davidpalma666/FED3.1-PCB-v7.x-FORK/_FED3.1 notes.txt

> meu repositório FORK
https://github.com/davidpalma666/FED3.1-PCB-v7.x-FORK

> o reposit´rio main

> doc instruções
https://docs.google.com/document/d/1KJnj2vmsR2Gq2-051aAo4KDC9eWGih1XZerS2I0B4w4/edit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

*************************************************
*	@30 Outubro 2025
*
> ontem Filipe com problemas na programação das 1ªs placas do lote de 200:
	- nem todas as placas ficavam programadas/havia-outros-erros diferentes numa amostragem de 10 PCBs

> veio-se a perceber q o problema derivava do cabo & ficha USB-tipoC
	- a ficha ficava com folga: neste momento não na PCB, apenas na máquina do Filipe
	- a forma como o cabo estava a ir no 'ar' da máquina para a PCB criava força de momento na ligação não ficando OK
	- a máquina do Filipe já ter 'muita' folga na ficha??? Talvez
	
> ficou esclarecido & reposto & garantindo a ligação mecânica firme da ficha-cabo à ficha-máquina

>mas anteve-se problemas futuros para o utilizador:
	- esta fragilidade mecânica do microUSB vai-se repercutir na PCB
	- em boards FED3 depois de utilizadas muitas vezes, a robustez mecânica da ficha vai enfraquecer & danificar contacto eléctrico
	- terá a ver com o 'cuidado' do utilizador? Tb, sim
	- mas a própria estrutura mecânica de soldadura da ficha é frágil e neste 1º lote os pinos mecânicos não vêem soldados - pinos TH sem soldadura no bottom layer
		!!!!! questão a ver com o produtor das PCBs na produção de um próximo lote

*************************************************
*	@29 Outubro 2025
*
> adicionada folder de \_fw ao commited

*************************************************
*	@15 Outubro 2025
*
." sincronizar o meu fork com o main branch" 
>> (??) já estava sincronizado?? havia files ainda diferentes;

>> garantia de sincronia com o main branch agora!!!

*************************************************
*	@26 Agosto 2025
*
>> FED3.1
	. meu @8 Agosto
		. Foi programado e viu-se as coisas a 'mexer', power e programação e LCD ok
		
	. Filipe @21 Agosto
			Percebi que o FED3 não carregava com um dos carregadores USB-C que tinha comigo
			Depis de várias testes, uma resistência de 1k ohm entre os 5V da ficha USB e GND resolveu.
					Dou como terminado oo desenvolvimento do FED3

			Fica aqui o link para a versão com a resistência entre a tensão de 5V da ficha USB e GND. Usei 330 ohms para termos mais corrente.
			https://github.com/KravitzLabDevices/FED3/tree/df9cc5ba60b0ba6e178a161061aa71733f4ab352
		. ecrã do FED3 passa a ter o OEPS PN OEPS100071
		. em produção 200un 
			
		. há ainda as PNs a corrigir no projecto?? 
		
		. sincronizar o meu fork com o main branch

*************************************************
*	@4 Julho 2025
*
- hw foi para produção
- footprints não totalmente em sintonia com as Libraries - propriedades mudadas
	- MPN corrigidos pelo Filipe
	- ficha USB & jack & switch: alterados para componentes SMD
	- gerado novos ficheiros P&P
	- mais algum alterado?? unsepecified 2 SMD?? - aqueles acima eram os criticos para aparecerem no P&P
	- redesenhado layer de Fabrication

- produzir documentação para Manufacturers programarem fws: para testes & final

*************************************************
*	@2 Julho 2025
*

from jonnew
https://github.com/KravitzLabDevices/FED3/issues/13

. Review of hardware 7.4 #13

1. "huge circle in the top silk layer"
Don't have that circle on my 'fork' version.
Also noticed about other differences on PCB file:
 . layers setup to be diferent - which layer were hidden or not
 . 'Zone Fills' to be drawn as Filled-Areas or Outlined
 
 While looking & working is perfectly legitim to change setups mentioned above.
 Maybe while doing it got that huge circle designed by mystake??
 For now can't imagine other reason...

2. "Fab layers are a mess".
Fab is short for "fabrication" layer (not "fabulous" as you might have guessed).
There's no requirement for it to contain anything or even to be sent to the PCB maker
It's can be used as PCB design auxiliary. Or time loosing if you won't used it for anything.
Characters & Numbers & Draws that will be printed on board are on Silkcreen layers, and this layers got and are 'clean'.

3. "board version (7.4) is nowhere that I can see."

*************************************************
*	@28 Maio 2025
*	

- headers ou sockets 2x3 para programação? 
	- o q é mais barato para utilizar na programação?
	- headeers sempre mais baratos q sockets
		- headers ~0.06€ / un @100n
			https://www.digikey.com/en/products/detail/metz-connect-usa-inc/PR20203VBDN/12342894
		- sockets ~0.25€ / un @100un
			https://www.digikey.com/en/products/detail/adam-tech/RS2-06-G/9832064
			
		>> UTILIZAR HEADERS;
		
- modificado pinout no header de programação para q GND & 3V3 não fiquem próximos
		OK

*************************************************
*	@27 Maio 2025
*

- v. corrigida na board para v.7.4 		OK

- USB: D+ & D- trocados ficha	- corrigido OK

- observação do Sérgio:
	. case de X2 não corresponde à do componente; difícil soldar
		- case corrigida	OK

- U2 MPN & OEPS corrigido
		OEPS080052	LDO 3.3V 300mA	SOT-23-5	SMD	MIC5504-3.3YM5-TR

*************************************************
*	@16 Maio 2025
*
- U2 - MPN errado
	. o q tá na component list:
		OEPS080165 
			MPN= SPX3819-3.3	NOK 
			SPN= MOUSER 701-SPX3819M5-L/TR	NOK
			Decription = LDO 3.3V 400mA 	NOK => Imax =500mA
		
		devia ser:
		SPX3819M5-L-3-3/TR	
			IC REG LINEAR 3.3V 500MA SOT23-5
		MPN = SPX3819M5-L-3-3/TR
		SPN =	1016-1873-6-ND		Digikey
					701-SPX3819M5-L-33TR 	Mouser
				
	. o utilizado agora para substituir:
		OEPS080052	LDO 3.3V 300mA	SOT-23-5	SMD	MIC5504-3.3YM5-TR
	>> FICOU ESTE O LDO A SER UTILIZADO

- USB: D+ & D- trocados ficha

*************************************************
*	@14 Maio 2025
*

>> revisão da programação do u SAMD21
	
	- o u é		ATSAMD21G18A		ATSAMD21G18A	 ARM Cortex M0
		. no kit	Adafruit Feather M0 Adalogger
			. ATSAMD21G18A - U - sem refª no pdf actual
			. ATSAMD21G18A-MU: TQFP48
			. OEPS100040 - OEPSPN do kit, não do u
	
		. na v.7.3 da PCB o u é:
			.  ATSAMD21G18A-MU	QFN48
			. OEPS080131

	- pinout fichas de Atmel-ICE programmer para  Feather M0 Adalogger 
	
		. tem de ser flat cable c\ condutores separados !!
				=>	o	o	o			#4	nc	#6				(top view & view from PCB edge)
						o	o	o			#1	#5	#2		
					
					=> AVR port => OK para o u !!!!!!!!!!!!1

		. pinout para condutores separados:	
				. AVR port
						#1 	SWCLCK		TCK	(verde)
						#2 	GND			GND
						#3 	n.c.				SWO = Serial Wire Output (optional- not implemented on all devices)
						#4 	3V3				VTG
						#5 	SWDIO		Serial Wire Debug Data Input/Output		(azul)
						#6 	RST				nRESET

				. SAM port
						#1 	3V3				VTG
						#2 	SWDIO		Serial Wire Debug Data Input/Output		(azul)
						#3 	GND			GND
						#4 	SWCLCK		TCK	(verde)
													#6	n.c.				SWO = Serial Wire Output (optional- not implemented on all devices)
						#10 	RST				nRESET

				. a ficha 3x2 não tem IOs necessários. Pinout:
						=>	#fio do flat q estão ligados na ficha 3x2	
						=>	o	o	o			#4	#9	#2				(top view)
								o	o	o			#3	#1	#6		
									||
						=>	FICHA NÃO UTILÁVEL EM NENHUMA DAS CONFIGURAÇÕES !!!

		- os ficheiros:
			. no UI Adafruit:
				1º bootloader setup:
					Tools -> Board -> SAMD21 boards -> Adafruit Feather M0
				2º bootloader upload:
						-> Tools -> Programmer: ATMEL-ICE
						-> Tools -> Burn bootloader
						
			. fw:	
				Tools -> Port -> COMx
					open 	\Documents\Arduino\libraries\FED3:	vários exemplos

*************************************************
*@15 Abril 2025

. RTC em versões anteriores:
	PCF8523T/1,118			SOIC8_150MIL	https://www.digikey.pt/en/products/detail/nxp-usa-inc/pcf8523t-1-118/2530422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
	
	package:	SO8 = SOIC8_150MIL = OEPS080167

. RTC para versão 7.3:
	PCF8523T K/1,118		
	package	HVSON8_4X4	??
		não - manteve-se a pesma package => mesmo PN

*************************************************
*@14 Abril 2025

. old v.7.2
	M74VHC1GT50DTT1G no .scmh
		IC3	1	IC BUFF CMOS LVL/SFTR N-I 5TSOP	SMD	M74VHC1GT125DT1G	Digi-Key	M74VHC1GT125DT1GOSCT-ND	

. new v.7.3
	SN74LV1T125DBVR
	- na v.7.2 valores no Scmh. e na BOM são diferentes
	- na BOM o valor é SN74LV1T125DBVR
	- é o q faz sentido com o desenho no Schm.

*************************************************
*@5 Fevereiro 2025
	https://developerhelp.microchip.com/xwiki/bin/view/products/mcu-mpu/8-bit-avr/structure/fuses/

*************************************************
*@28 Janeiro 2025

https://forum.arduino.cc/t/solved-programming-a-samd21-with-the-atmel-ice-from-the-ide/434482
	
	>> to get rid of it and use the ATMEL-ICE and program the boards via SWD (Atmel-Ice não para pinos SWD??)
		- para quê o SWD??
		
	- The way that I do it right now is 
	1. I burn a sketch on a dev board via USB, 
	2. then read the flash with Atmel Studio, 
	3. and use that image to flash the other boards 
	...This is a bit a pain in the ass, as I changed the footprint of my programming socket in the board, and I have to fiddle with wires everytime I switch boards.

	Has somebody been successful using the IDE and the ATMEL-ICE to flash SAMD21 chips??
	
	Hi, you need to compile your code using a different linker script:

*************************************************
*@27 Janeiro 2025

>>meta para conseguir programar o micro:

	1. programar o bootloader no micro ainda virgem e 
	
		- para programar micro ainda virgem será necessário header SwClck & SwDIO & \Reset	>>	OK
		
		- micro pode ser programado pela porta SAMD21 ou IDE do programador : 
			. pinout do flat cable diferente; ver pic no caderno		>>	OK
		
		- é realmente necessário colocar bootloader ?? ... 
			. sim, para a seguir o micro ficar programável por USB		>>	OK
		
		- tem de ser todo o código do kit Adafruitxxx da placas já com bootloader & IO-setup etc, ou
			ou,
			haverá código q é apenas o bootloader & COMM setup - sem mais nada & mais simples?

	2. colocar depois o nosso código 
		- via USB & o nosso programa OEPS-programming	>>OK ????
		
		- pq não continuar a usar o AdaProgrammer via SwClck & SwDIO & \Reset??

	3. o micro
	Adafruit Feather M0 Adalogger
	ATSAMD21G18AU
	ATSAM D21 G 18A -U
		OEPS080131	ATSAM D21 G 18A- MU		
		IC MCU 32BIT 256KB FLASH 48QFN	48-VFQFN Exposed Pad	SMD	ATSAMD21G18A-MU

	https://pt.farnell.com/microchip/atsamd21g18a-mf/mcu-32bit-cortex-m0-48mhz-qfn/dp/2460544
	
	:: de SAM D21 family .pdf
	- Note that a pull-up resistor on the SWCLK pin is critical for reliable operations. Refer to related link for more information.

*************************************************
*@24 Janeiro 2025
- novo switch a mudar/implementar no desenho - mais pequeno
	filtro:
	https://www.digikey.pt/en/products/filter/tactile-switches/197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
	
	modelo
	https://www.digikey.pt/en/products/detail/e-switch/TL3305BF260QG/5816185
	E-Switch
	4.5 X 4.5 mm
	0.25@1		0.16@100
	MPN: TL3305BF260QG
	Digikey: EG5354CT-ND

*************************************************
*@23 Janeiro 2025

>> escolha reset switch dentro do q já temos
OTHER:   SWITCH TACTILE SPST-NO 0.05A 24V   [B3F-1002] [TH]	OEPS100011	TH	B3F-1002		https://www.digikey.pt/en/products/detail/omron-electronics-inc-emc-div/b3f-1002/11881
	side-switch 	NOK

OTHER:   SWITCH TACTILE SPST-NO 0.05A 24V   [B3F-4000] [TH]	OEPS100020	TH	B3F-4000	1	DigiKey	SW411-ND
https://www.digikey.pt/en/products/detail/omron-electronics-inc-emc-div/b3f-4000/63961
	12mm x 12mm;	4.3mm height		flat type OK		
	há mais peq q 12x12	- NOK- grande	

OTHER:   SWITCH TACTILE SPST-NO 0.05A 50V   [CT11027.0F160] [TH]	OEPS100056	TH	CT11027.0F160	1	Digikey	2449-CT11027.0F160-ND
https://www.digikey.pt/en/products/detail/cit-relay-and-switch/ct11027-0f160/12502785
	CT1102	standard
		7.0	actuator height
		F160	actuator force
		XxY = 6mm x 6mm
			OK?? 	maior......

*************************************************
*@21 Janeiro 2025

- Board redesenhada: integração de Atmel 'as-is' na nossa board

>> substituir componentes da board Atmel, por componentes nossos & similares:
	- D2		
			Schottky	MBR120	
				Case													SOD-123
				Voltage - DC Reverse (Vr) (Max)		20 V
				Current - Average Rectified (Io)		1A
				Voltage - Forward (Vf) (Max) @ If	450 mV @ 1 A
				Speed												Fast Recovery =< 500ns, > 200mA (Io)
			
			SM5817PL-TP			OEPS030030
				Case 		SOD-123FL			<<<<<<<<<<<<<<<<!!!!!!!!! OK ???
				Voltage - DC Reverse (Vr) (Max)		20 V
				Current - Average Rectified (Io)		1A
				Voltage - Forward (Vf) (Max) @ If	450 mV @ 1 A
				Speed									Fast Recovery =< 500ns, > 200mA (Io)

	- RGB LEDs
			- spec apenas leva até case & protocolo comm..			https://www.digikey.pt/en/products/filter/led-addressable-specialty/126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

		L0	Red
			OEPS030006	LED 0603 Red 635nm 20mA	0603	SMD	5975004407F	10	DigiKey	350-2950-6-ND
			>> OK
		
	 - Green LEDs
	OEPS030005= DigiKey: 160-1446-6-ND
	>>> OK

	- SW2	Reset switch	Push-Butt SMD	
		a escolher dos nossos
	
	- 10uF		Cs com case 0402 muito mais caros q case 0603? E disponibilidade??
		a escolher dos nossos

>>lista re-enviada ao Filipe @ 23 Janeiro 

	- USB micro plug	.Actual one:	. OEPS070062USB 2.0 MICRO B R/ASMD/THZX62D-B-5P8(30)1DigiKey H125272DKR-ND	> obsolete - last production by November 2025	> 0.30€ expensive than new one		> new one below fully compatible electrically & mechanically 	

	. NEW micro plug	https://www.digikey.pt/en/products/detail/hirose-electric-co-ltd/ZX62D-B-5PA8-30/5994877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	USB 2.0 MICRO B R/A	SMD/TH	MPN: ZX62D-B-5PA8(30)	DigiKey: H125718CT-ND	OEPSPN: OEPS07????
	
	- SW1main switchmanter o mesmo(?) pq (re-)integração mecânica mais fácil	https://www.digikey.pt/en/products/detail/alps-alpine/ssss811101/19529062	Slide Switch SPDT Surface Mount, Right Angle 0.3A 5V	MPN: SSSS811101	Digikey: 4809-SSSS811101CT-ND	OEPSPN: OEPS10????

	Micro SDCard conn	https://www.digikey.pt/en/products/detail/w%C3%BCrth-elektronik/693071010811/3124583	CONN MICRO SD CARD PUSH-PUSH R/A		SMD	MPN	693071010811	Digikey	732-3819-1-ND	OEPS07????					
	
	IC BUF NON-INVERT 1CH 5.5V 	https://www.digikey.pt/en/products/detail/texas-instruments/SN74LV1T125DBVR/4555571	SOT23-5	MPN	SN74LV1T125DBVR	Digikey	296-37172-1-ND	OEPSPN	OEPS08????					
	
	IC BATT CNTL LI-ION 1CEL 	https://www.digikey.pt/en/products/detail/microchip-technology/mcp73831t-2aci-ot/964301	SOT23-5	MPN	MCP73831T-2ACI/OT	Digikey	MCP73831T-2ACI/OTCT-ND	OEPSPN	OEPS08????						
	
	IC MOTOR DRIVER 2.7V-5.5V 	https://www.digikey.pt/en/products/detail/toshiba-semiconductor-and-storage/tb6612fng-c-8-el/1730070	24SSOP	MPN	TB6612FNG,C,8,EL	Digikey	TB6612FNGC8ELCT-ND	OEPSPN	OEPS08????					
	
	IC RTC CLOCK/CALENDAR I2C 	https://www.digikey.pt/en/products/detail/nxp-usa-inc/pcf8523t-1-118/2530422	8SO	MPN	PCF8523T/1,118	Digikey	568-5306-1-ND	OEPSPN	OEPS0?????					
	
	XTAL 32.7680KHZ ±10ppm 12.pPF SMD	https://www.digikey.pt/en/products/detail/ecs-inc/ECS-327-12-5-17X-C-TR/2781917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	SMD	MPN	ECS-.327-12.5-17X-C-TR	Digikey	XC1912CT-ND	OEPSPN	OEPS03????					
	
	Battery Retainer Coin, 12.0mm 1 Cell	https://www.digikey.pt/en/products/detail/keystone-electronics/3000/227440	SMD	MPN	3000	Digikey	36-3000-ND	OEPSPN	OEPS0?????
	
	Optical Sensor Through-Beam 10mm PCB Mount	https://www.digikey.pt/en/products/detail/sharp-socle-technology/gp1a57hrj00f/718287	MPN	GP1A57HRJ00F	Digikey	1855-1043-ND	OEPSPN	OEPS??????					
	
	GRAPHIC DISPLAY LCD BLACK (GRAY)	https://www.digikey.pt/en/products/detail/adafruit-industries-llc/3502/7386264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	MPN	3502	Digikey	1528-2326-ND	OEPSPN	OEPS??????							

*************************************************
*@2 Janeiro 2025

	:: início Janeiro 2025
	1. FED3.1	> produto de controle acção-recompensa para ratos
		- objectivo:
			integração do kit Arduino 'Feather M0 Adalogger' na nossa main board FED3.1

. 	O FED3 base PCB está nesta pasta do Google Drive
\production files\FED3\OEPS-7504 - FED3.1 PCB\pcb\v7.2\oeps files\

. A BOM na pasta
\production files\FED3\OEPS-7504 - FED3.1 PCB\pcb\v7.2\production files\

. Este é o módulo Adafruit 	Adafruit Feather M0 Adalogger
	https://www.adafruit.com/product/2796
	
	 Feather M0's heart is an ATSAMD21G18 ARM Cortex M0 processor
	
. Os ficheiros do módulo Adalogger
	https://github.com/adafruit/Adafruit-Feather-M0-Adalogger-PCB

**************************************************************************************************
**************************************************************************************************
