davidpalma666/FED3.1-PCB-v7.x-FORK/pcb/_auxs/FED3_v7.2_BOM_simplified.xlsx

Schematic Name / Name | Qtty. | Description | Type | Manufacturer PN
IC1 | 1 | RTC (SOIC8_150MIL) | SMD | PCF8523T/1,118
IC2 | 1 | Motor driver (SSOP24) | SMD | TB6612FNG,C,8,EL
IC3 | 1 | IC BUFF CMOS LVL/SFTR N-I 5TSOP | SMD | M74VHC1GT125DT1G
R1, R2, R3, R6 | 4 | RES SMD 0805 1kΩ 1% 125mW | SMD | RC0805FR-071KL
R4, R5, R8 | 3 | RES SMD 0805 4.7kΩ 1% 125mW | SMD | RC0805FR-074K7L
R9 | 1 | RES SMD 0805 33kΩ 1% 125mW | SMD | CR0805-FX-3302ELF
R7 (DNI) | 0 | - | SMD | -
R12 | 1 | CAP SMD 0805 470Ω 1% 125mW | SMD | ERJ-6ENF4700V
C1, C2, C3, C4, C5, C6, C7, C8, C9, C10 | 10 | CAP SMD 0805 10uF 25V X5R 10% | SMD | TMK212BBJ106KG-T
Q1 | 1 | 32.768KHz Crystal | SMD | ECS-.327-12.5-17X-C-TR
Q3 | 1 | MOSFET 4V PCH | SMD | 755-RRR040P03TL
LED1, LED2, LED3, LED4, LED5, LED6, LED7, LED8, LED9, LED10 | 10 | RGB | SMD | SK6812RGBW-BW
B1 | 1 | CR1220 | SMD | Mouser: 534-3000
BEEP | 1 | Buzzer | TH | PS1240P02BT
USB | 1 | CONN RCPT USB MICRO B SMD | SMD/TH | ZX62D-B-5P8(30)
D1 | 1 | DIODE SCHOTTKY 25V 1.5A DO214AC | SMD | BYS10-25-E3/TR
SW1 | 1 | SWITCH | SMD | SSSS811101
EXT | 1 | AUDIO JACK | SMD | 35RASMT2BHNTRX
H7 FEATHER | 1 | Fem Header 1X12 100mil (2.54mm) | TH | CES-112-01-T-S
H5 FEATHER | 1 | Fem Header 1X16 100mil (2.54mm) | TH | CES-116-01-T-S
H3 MOTOR | 1 | Header 1x5 100mil (2.54mm) | TH | M20-9990546
PI1, PI2, PI3 | 3 | GP1A57HR | TH | GP1A57HRJ00F
X1 | 1 | JST CONN HEADER VERT 2POS 2MM | TH | B2B-PH-K-S(LF)(SN)
AUX_I2C (DNI) | 0 | DNI | - | -
H1 SCREEN | 1 | Header RA 1X6 100mil (2.54mm) | TH | 61300611021
This eval board is soldered by hand after the board is ready
EVAL BOARD | 1 | uC: Feather M0 Adalogger | - | DigiKey: 1528-1539-ND
HEADER FOR EVAL BOARD | 1 | Header 1X12 100mil (2.54mm) |  | TSW-112-06-T-S
HEADER FOR EVAL BAORD | 1 | Header 1X16 100mil (2.54mm) |  | TSW-116-06-T-S
This eval screen is soldered by hand after the board is ready
DISPLAY | 1 | SHARP memory display 1.3" 168x144 | - | DigiKey: 1528-2326-ND
SMD | 39
TH top | 6
TH bottom | 3
SMD different | 16
TH different | 7
