davidpalma666/FED3.1-PCB-v7.x-FORK/fw/_othersss/install and configure arduino packages.docx

Install:

- Arduino IDE v2.3.2 (available in the same folder as this file)
- File > Preferences > Additional Boards Manager URLs: https://adafruit.github.io/arduino-board-index/package_adafruit_index.json  Note: The list of URLs is comma separated
- The list of URLs is comma separated Board’s Management: Arduino SAMD Boards (32-bits ARM Cortex-M0+) v1.8.14
- Board’s Management: Adafruit SAMD Boards v1.7.3
- Library Management: FED3 v1.16.3 > INSTALL ALL

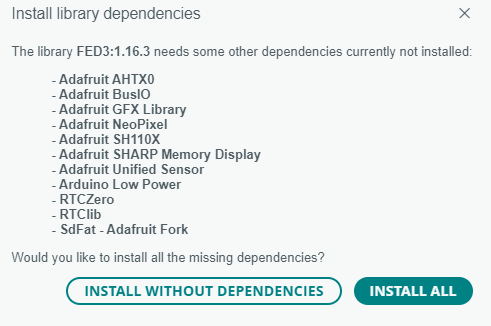
[picture p2: figure]
