davidpalma666/FED3.1-PCB-v7.x-FORK/pcb/v7.7/FED3.kicad_pcb

## KiCad design pcb/v7.7/FED3.kicad_pcb (2026-04-23)

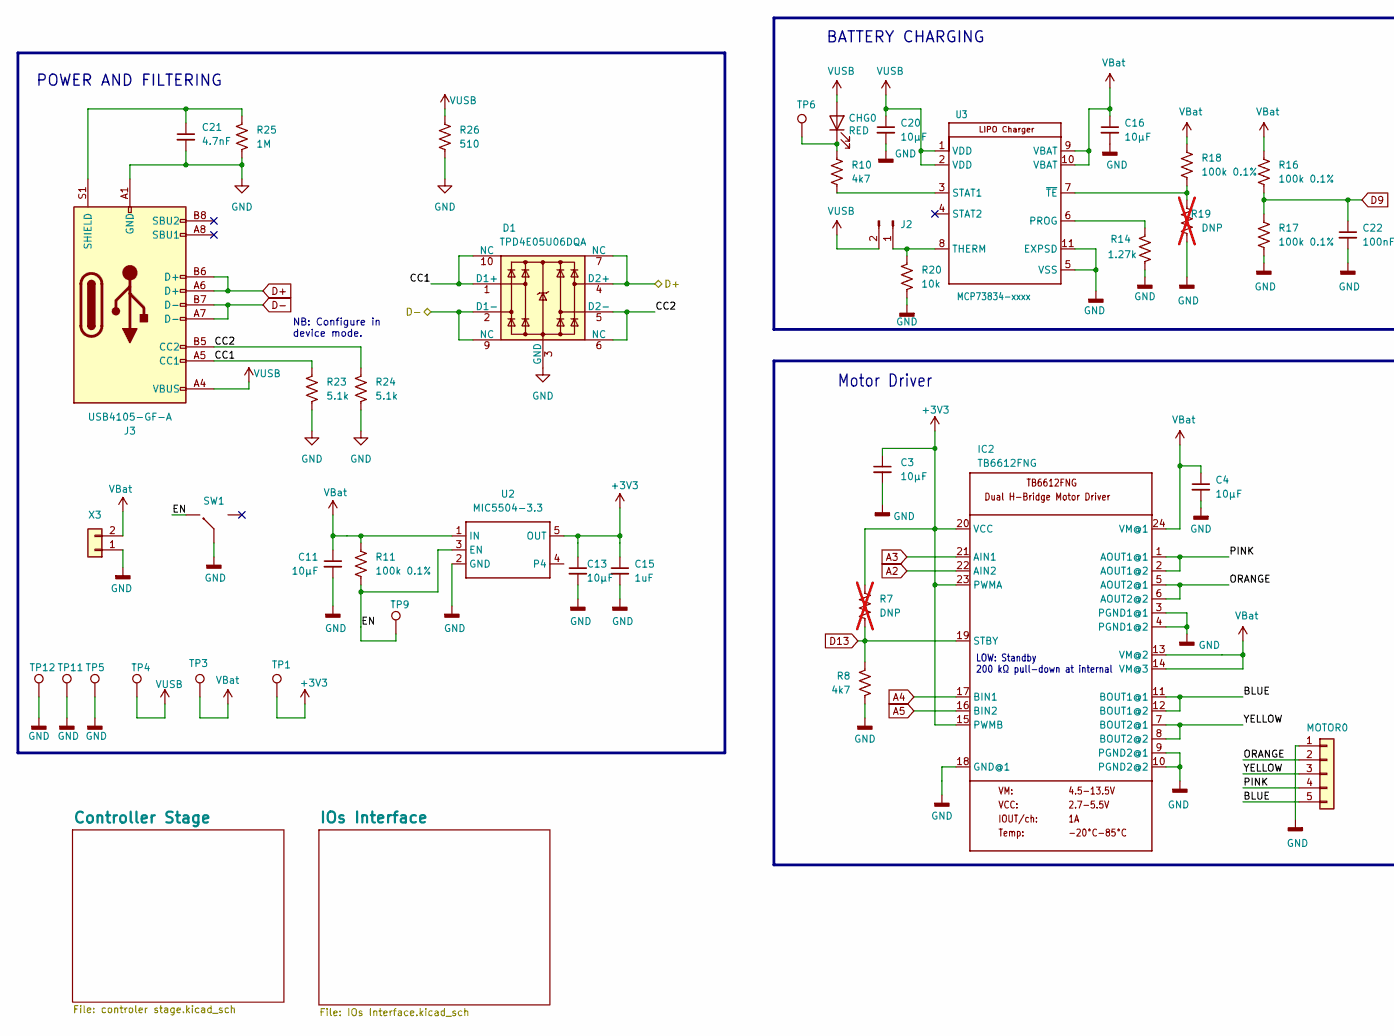
[picture p3: schematic FED3.kicad_sch, FED3 Control Board, part in row 1, column 1]

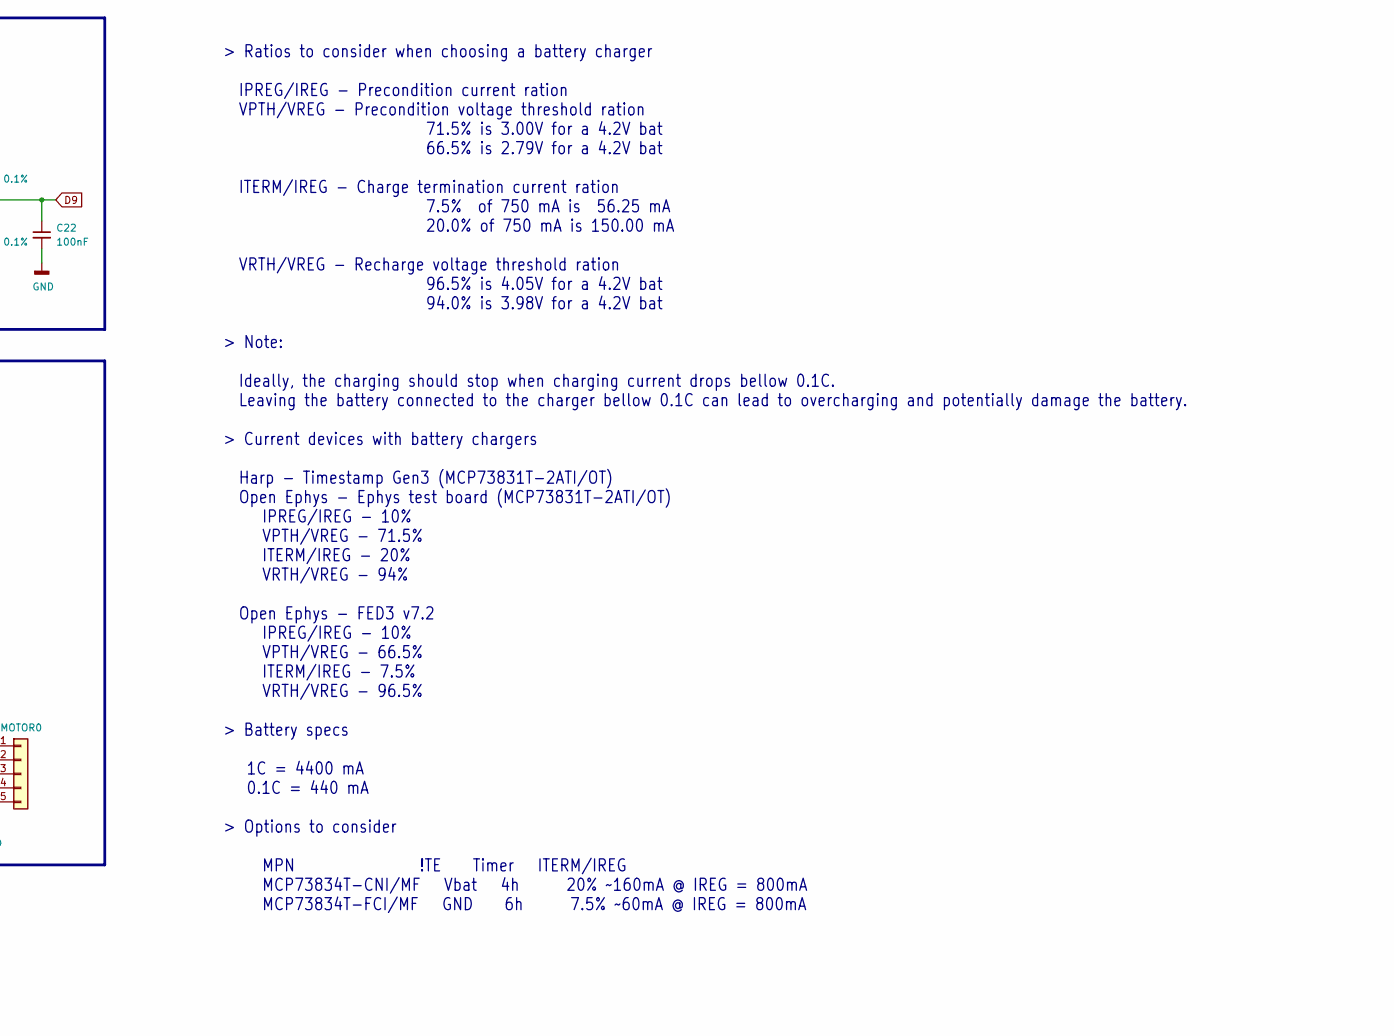
[picture p4: schematic FED3.kicad_sch, FED3 Control Board, part in row 1, column 2]

Parts:
C3, C4, C11, C13, C16, C20: 10µF; C_0402_1005Metric; MPN CL05A106MP5NUNC
C15: 1uF; C_0402_1005Metric; MPN C1005X5R1E105K050BC
C21: 4.7nF; C_0402_1005Metric; MPN 885012205084
C22: 100nF; C_0402_1005Metric; MPN C1005X7R1E104K050BB
CHG0: RED; LED_0603_1608Metric; MPN VFHR1116P-4C82A-TR
D1: TPD4E05U06DQA; USON-10_2.5x1.0mm_P0.5mm; MPN TPD4E05U06DQAR
IC2: TB6612FNG; SSOP24; MPN TB6612FNG,C,8,EL
J2: Conn_01x02_Odd_Even; PinHeader_1x02_P2.54mm_Vertical; MPN 68001-202HLF
J3: USB4105-GF-A; USB_C_Receptacle_GCT_USB4105-xx-A_16P_TopMnt_Horizontal; MPN USB4105-GF-A
MOTOR0: PINHD-1X5; 1X05; MPN M20-9990546
R7, R19: DNP; R_0402_1005Metric; MPN n.a.; not fitted
R8, R10: 4k7; R_0402_1005Metric; MPN ERJ-2RKF4701X
R11, R16, R17, R18: 100k 0.1%; R_0402_1005Metric; MPN RG1005P-104-B-T5
R14: 1.27k; R_0402_1005Metric; MPN CRCW04021K27FKED
R20: 10k; R_0402_1005Metric; MPN ERJ-2RKF1002X
R23, R24: 5.1k; R_0402_1005Metric; MPN ERJ-2RKF5101X
R25: 1M; R_0402_1005Metric; MPN CRCW04021M00FKED
R26: 510; R_0805_2012Metric; MPN ESR10EZPJ391
SW1: Sw; SSSS811101; MPN SSSS811101
TP1, TP6: 3V3; TestPoint_Pad_D2.0mm
TP3: VBat; TestPoint_Pad_D2.0mm
TP4, TP9: VUSB; TestPoint_Pad_D2.0mm
TP5, TP11, TP12: GND; TestPoint_Pad_D2.0mm
U2: MIC5504-3.3; SOT-23-5; MPN MIC5504-3.3YM5-TR
U3: MCP73834-xxxx; DFN-10-1EP_3x3mm_P0.5mm_EP1.58x2.35mm_ThermalVias; MPN MCP73834-CNI/MF
X3: B2B-PH-K-S; JST-XH-02-PACKAGE-ROUND-PAD; MPN B2B-PH-K-S(LF)(SN)

Connections:
+3V3: C3.1, C13.1, C15.1, IC2.15 (PWMB), IC2.20 (VCC), IC2.23 (PWMA), R7.2, TP1.1, U2.5 (OUT); also elsewhere on the board
/BLUE: IC2.11 (BOUT1@1), IC2.12 (BOUT1@2), MOTOR0.5
/CC1: D1.1 (D1+), D1.10 (NC), J3.A5 (CC1), R23.1
/CC2: D1.5 (D2-), D1.6 (NC), J3.B5 (CC2), R24.1
/EN: R11.2, SW1.1, TP9.1, U2.3 (EN)
/ORANGE: IC2.5 (AOUT2@1), IC2.6 (AOUT2@2), MOTOR0.2
/PINK: IC2.1 (AOUT1@1), IC2.2 (AOUT1@2), MOTOR0.4
/YELLOW: IC2.7 (BOUT2@1), IC2.8 (BOUT2@2), MOTOR0.3
A2: IC2.22 (AIN2); also elsewhere on the board
A3: IC2.21 (AIN1); also elsewhere on the board
A4: IC2.17 (BIN1); also elsewhere on the board
A5: IC2.16 (BIN2); also elsewhere on the board
D9: C22.1, R16.1, R17.1; also elsewhere on the board
D13: IC2.19 (STBY), R7.1, R8.2; also elsewhere on the board
D+: D1.4 (D2+), D1.7 (NC), J3.A6 (D+), J3.B6 (D+); also elsewhere on the board
D-: D1.2 (D1-), D1.9 (NC), J3.A7 (D-), J3.B7 (D-); also elsewhere on the board
GND: C3.2, C4.2, C11.2, C13.2, C15.2, C16.2, C20.2, C21.2, C22.2, D1.3 (GND), D1.8 (GND), IC2.3 (PGND1@1), IC2.4 (PGND1@2), IC2.9 (PGND2@1), IC2.10 (PGND2@2), IC2.18 (GND@1), J3.A1 (GND), J3.A12 (GND), J3.B1 (GND), J3.B12 (GND), MOTOR0.1, R8.1, R14.2, R17.2, R19.2, R20.2, R23.2, R24.2, R25.2, R26.2, SW1.2, TP5.1, TP11.1, TP12.1, U2.2 (GND), U3.5 (VSS), U3.11 (EXPSD), X3.1; also elsewhere on the board
unnamed: CHG0.1 (K), R10.1, TP6.1
unnamed: J2.1, R20.1, U3.8 (THERM)
unnamed: C21.1, J3.S1 (SHIELD), R25.1
unnamed: R14.1, U3.6 (PROG)
unnamed: R10.2, U3.3 (STAT1)
unnamed: R18.1, R19.1, U3.7 (~TE)
VBat: C4.1, C11.1, C16.1, IC2.13 (VM@2), IC2.14 (VM@3), IC2.24 (VM@1), R11.1, R16.2, R18.2, TP3.1, U2.1 (IN), U3.9 (VBAT), U3.10 (VBAT), X3.2; also elsewhere on the board
VUSB: C20.1, CHG0.2 (A), J2.2, J3.A4 (VBUS), J3.A9 (VBUS), J3.B4 (VBUS), J3.B9 (VBUS), R26.1, TP4.1, U3.1 (VDD), U3.2 (VDD)

Notes on the sheet:
Motor Driver
POWER AND FILTERING
BATTERY CHARGING
NB: Configure in device mode.
> Ratios to consider when choosing a battery charger IPREG/IREG - Precondition current ration VPTH/VREG - Precondition voltage threshold ration 71.5% is 3.00V for a 4.2V bat 66.5% is 2.79V for a 4.2V bat ITERM/IREG - Charge termination current ration 7.5% of 750 mA is 56.25 mA 20.0% of 750 mA is 15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
LOW: Standby 200 kΩ pull-down at internal

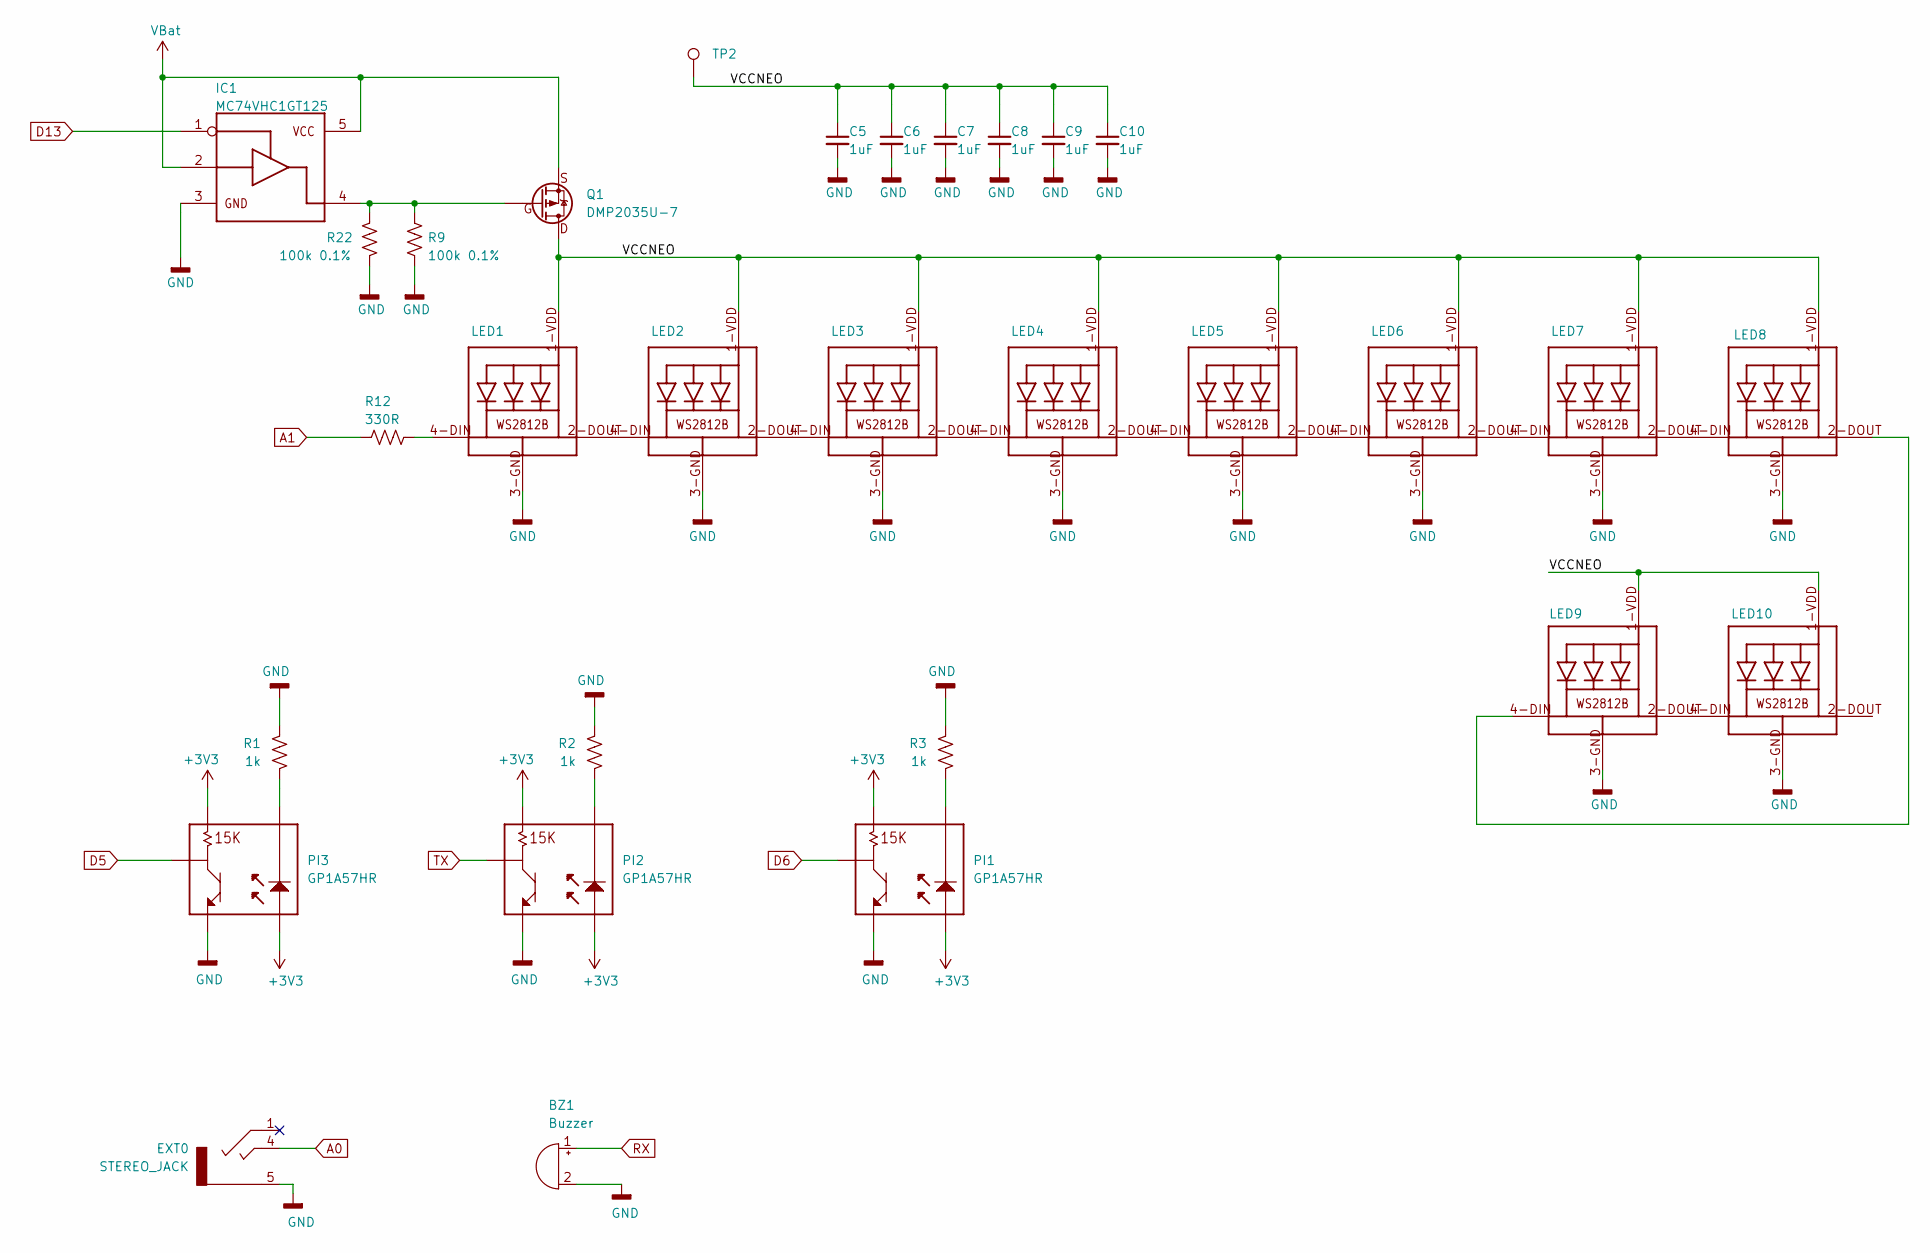
[picture p5: schematic IOs Interface.kicad_sch, FED3 Control Board]

Parts:
BZ1: Buzzer; MPN PS1240P02BT
C5, C6, C7, C8, C9, C10: 1uF; C_0402_1005Metric; MPN C1005X5R1E105K050BC
EXT0: STEREO_JACK; 35RASMT2BHNTRX; MPN 35RASMT2BHNTRX
IC1: MC74VHC1GT125; SOT-23-5; MPN MC74VHC1GT125DBVT1G
LED1, LED2, LED3, LED4, LED5, LED6, LED7, LED8, LED9, LED10: RGBLed; WS2812B; MPN XT1511RGBW-BW
PI1, PI2, PI3: GP1A57HR; MPN GP1A57HRJ00F
Q1: DMP2035U-7; TSMT3; MPN DMP2035U-7
R1, R2, R3: 1k; R_0402_1005Metric; MPN ERJ-2RKF1001X
R9, R22: 100k 0.1%; R_0402_1005Metric; MPN RG1005P-104-B-T5
R12: 330R; R_0402_1005Metric; MPN RC0402FR-07330RL
TP2: VccNEO; TestPoint_Pad_D2.0mm

Connections:
+3V3: PI1.1, PI1.3, PI2.1, PI2.3, PI3.1, PI3.3; also elsewhere on the board
/IOs Interface/VCCNEO: C5.1, C6.1, C7.1, C8.1, C9.1, C10.1, LED1.1-VDD (VDD), LED2.1-VDD (VDD), LED3.1-VDD (VDD), LED4.1-VDD (VDD), LED5.1-VDD (VDD), LED6.1-VDD (VDD), LED7.1-VDD (VDD), LED8.1-VDD (VDD), LED9.1-VDD (VDD), LED10.1-VDD (VDD), Q1.P$3 (D), TP2.1
A0: EXT0.4; also elsewhere on the board
A1: R12.2; also elsewhere on the board
D5: PI3.4; also elsewhere on the board
D6: PI1.4; also elsewhere on the board
D13: IC1.1; also elsewhere on the board
GND: BZ1.2 (-), C5.2, C6.2, C7.2, C8.2, C9.2, C10.2, EXT0.5, IC1.3, LED1.3-GND (GND), LED2.3-GND (GND), LED3.3-GND (GND), LED4.3-GND (GND), LED5.3-GND (GND), LED6.3-GND (GND), LED7.3-GND (GND), LED8.3-GND (GND), LED9.3-GND (GND), LED10.3-GND (GND), PI1.5, PI2.5, PI3.5, R1.2, R2.2, R3.2, R9.1, R22.1; also elsewhere on the board
unnamed: IC1.4, Q1.P$1 (G), R9.2, R22.2
unnamed: LED1.4-DIN (DI), R12.1
unnamed: LED1.2-DOUT (DO), LED2.4-DIN (DI)
unnamed: LED2.2-DOUT (DO), LED3.4-DIN (DI)
unnamed: LED3.2-DOUT (DO), LED4.4-DIN (DI)
unnamed: LED4.2-DOUT (DO), LED5.4-DIN (DI)
unnamed: LED5.2-DOUT (DO), LED6.4-DIN (DI)
unnamed: LED6.2-DOUT (DO), LED7.4-DIN (DI)
unnamed: LED7.2-DOUT (DO), LED8.4-DIN (DI)
unnamed: LED8.2-DOUT (DO), LED9.4-DIN (DI)
unnamed: LED9.2-DOUT (DO), LED10.4-DIN (DI)
unnamed: PI1.2, R3.1
unnamed: PI2.2, R2.1
unnamed: PI3.2, R1.1
RX: BZ1.1 (+); also elsewhere on the board
TX: PI2.4; also elsewhere on the board
VBat: IC1.2, IC1.5, Q1.P$2 (S); also elsewhere on the board

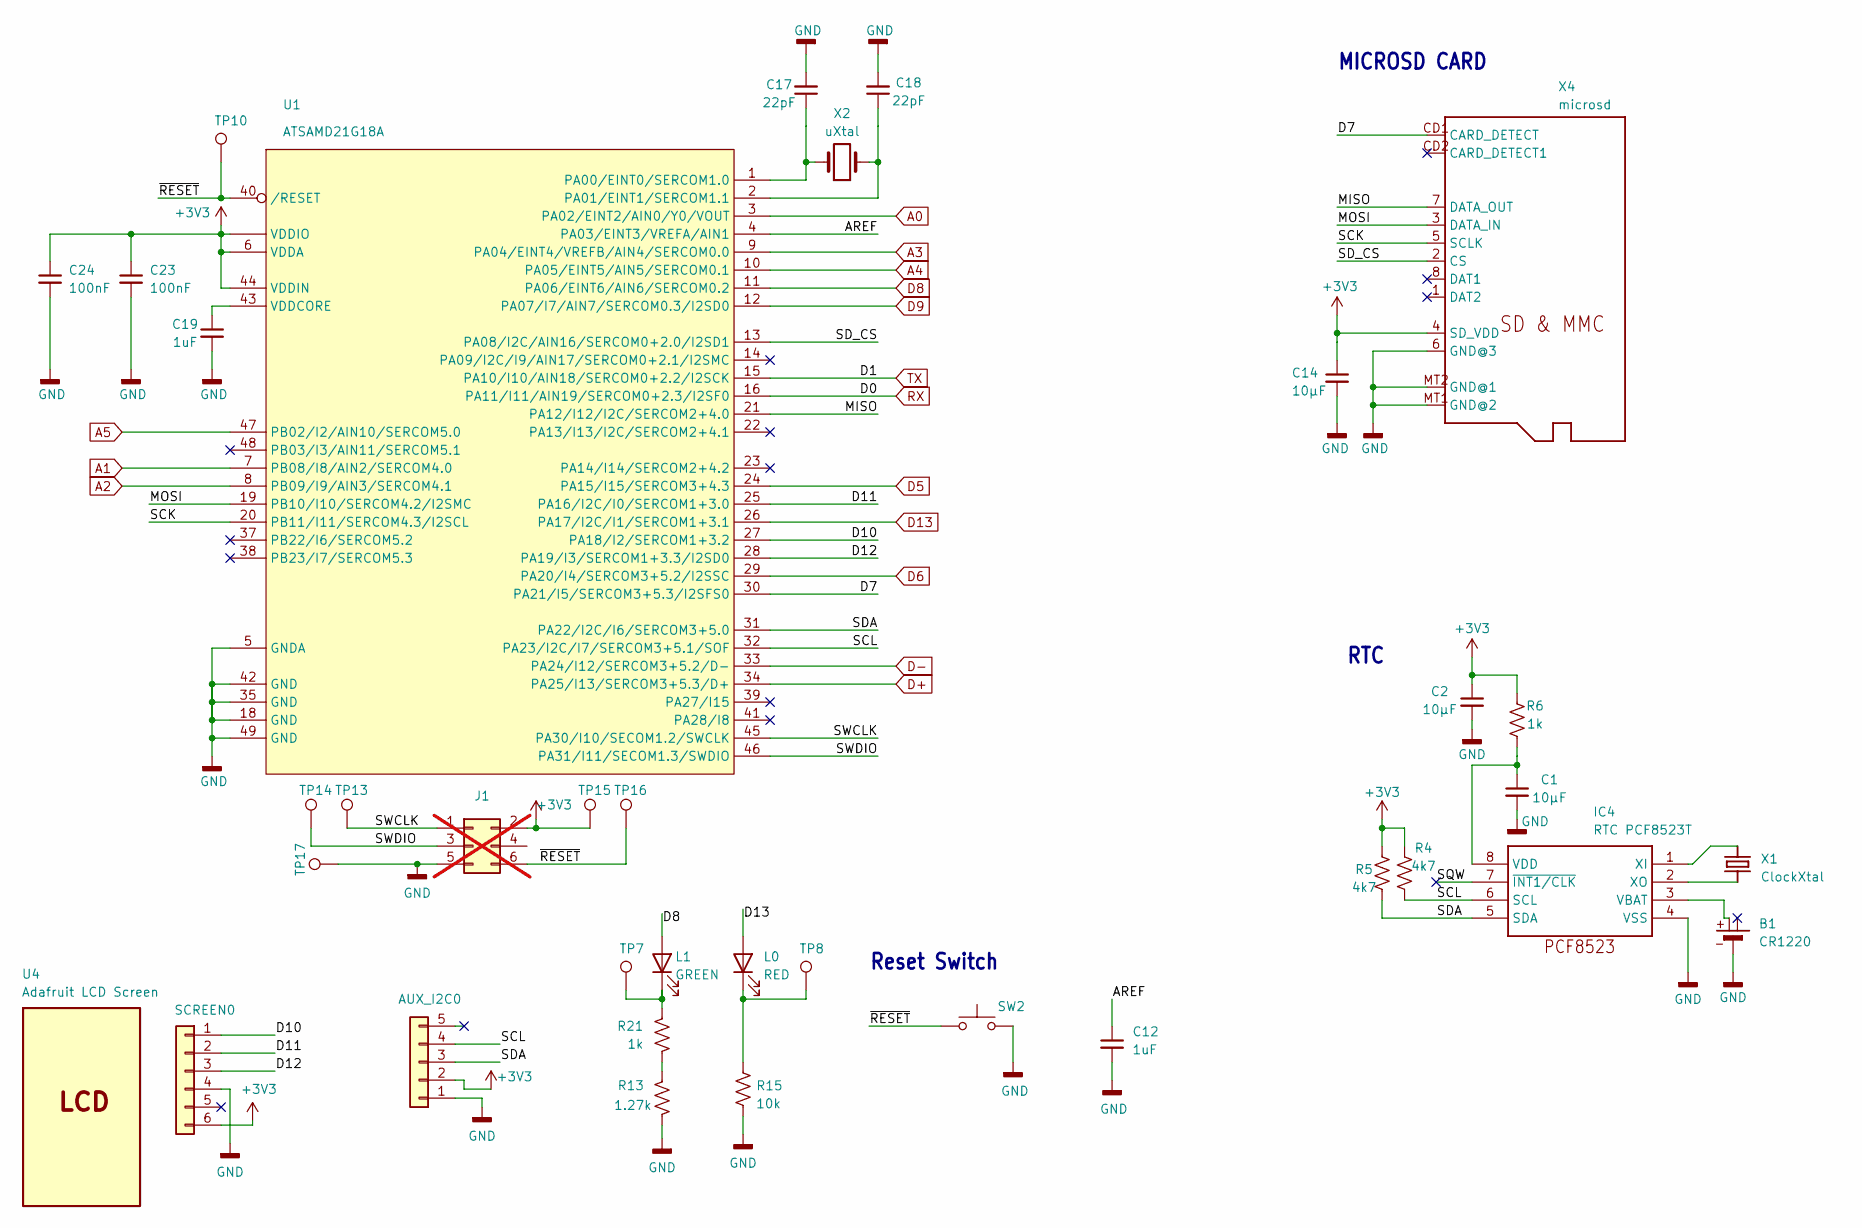
[picture p6: schematic controler stage.kicad_sch, FED3 Control Board]

Parts:
AUX_I2C0: Qwiic; JST_SH_BM04B-SRSS-TB_1x04-1MP_P1.00mm_Vertical; MPN BM04B-SRSS-TB(LF)(SN)
B1: CR1220; MPN 534-3000
C1, C2, C14: 10µF; C_0402_1005Metric; MPN CL05A106MP5NUNC
C12, C19: 1uF; C_0402_1005Metric; MPN C1005X5R1E105K050BC
C17, C18: 22pF; C_0402_1005Metric; MPN CL05C220JB51PNC
C23, C24: 100nF; C_0402_1005Metric; MPN C1005X7R1E104K050BB
IC4: RTC PCF8523T; SO-8_3.9x4.9mm_P1.27mm; MPN PCF8523T/1,118
J1: Conn_02x03_Odd_Even; PinHeader_2x03_P2.54mm_Vertical; MPN PR20203VBDN; not fitted
L0: RED; LED_0603_1608Metric; MPN VFHR1116P-4C82A-TR
L1: GREEN; LED_0603_1608Metric; MPN 150060VS75000
R4, R5: 4k7; R_0402_1005Metric; MPN ERJ-2RKF4701X
R6, R21: 1k; R_0402_1005Metric; MPN ERJ-2RKF1001X
R13: 1.27k; R_0402_1005Metric; MPN CRCW04021K27FKED
R15: 10k; R_0402_1005Metric; MPN ERJ-2RKF1002X
SCREEN0: PINHD-1X6; 1X06; MPN 61300611021
SW2: SPST_TACT-KMR2; SW_SPST_TL3305B; MPN TL3305BF260QG
TP7, TP8, TP10: 3V3; TestPoint_Pad_D2.0mm
TP13, TP14, TP15, TP16, TP17: GND; TestPoint_Pad_D2.0mm
U1: ATSAMD21G18A; TQFN48_7MM; MPN ATSAMD21G18A-MU
U4: Adafruit LCD Screen; MPN 3502
X1: ClockXtal; CRYSTAL_8X3.8; MPN ECS-.327-12.5-17X-C-TR
X2: uXtal; Crystal_SMD_MicroCrystal_CC8V-T1A-2Pin_2.0x1.2mm; MPN 9HT11-32.768KBZF-T
X4: microsd; MICROSD; MPN 693071010811

Connections:
+3V3: AUX_I2C0.2, C2.1, C14.1, C23.1, C24.1, J1.2, R4.1, R5.2, R6.1, SCREEN0.6, TP15.1, U1.6 (VDDA), U1.17 (VDDIO), U1.36 (VDDIO), U1.44 (VDDIN), X4.4 (SD_VDD); also elsewhere on the board
/Controller Stage/AREF: C12.1, U1.4 (PA03/EINT3/VREFA/AIN1)
/Controller Stage/D7: U1.30 (PA21/I5/SERCOM3+5.3/I2SFS0), X4.CD1 (CARD_DETECT)
/Controller Stage/D10: SCREEN0.1, U1.27 (PA18/I2/SERCOM1+3.2)
/Controller Stage/D11: SCREEN0.2, U1.25 (PA16/I2C/I0/SERCOM1+3.0)
/Controller Stage/D12: SCREEN0.3, U1.28 (PA19/I3/SERCOM1+3.3/I2SD0)
/Controller Stage/MISO: U1.21 (PA12/I12/I2C/SERCOM2+4.0), X4.7 (DATA_OUT)
/Controller Stage/MOSI: U1.19 (PB10/I10/SERCOM4.2/I2SMC), X4.3 (DATA_IN)
/Controller Stage/SCK: U1.20 (PB11/I11/SERCOM4.3/I2SCL), X4.5 (SCLK)
/Controller Stage/SCL: AUX_I2C0.4, IC4.6 (SCL), R4.2, U1.32 (PA23/I2C/I7/SERCOM3+5.1/SOF)
/Controller Stage/SDA: AUX_I2C0.3, IC4.5 (SDA), R5.1, U1.31 (PA22/I2C/I6/SERCOM3+5.0)
/Controller Stage/SD_CS: U1.13 (PA08/I2C/AIN16/SERCOM0+2.0/I2SD1), X4.2 (CS)
/Controller Stage/SQW: IC4.7 (~INT1/CLK)
/Controller Stage/SWCLK: J1.1, TP13.1, U1.45 (PA30/I10/SECOM1.2/SWCLK)
/Controller Stage/SWDIO: J1.3, TP14.1, U1.46 (PA31/I11/SECOM1.3/SWDIO)
/Controller Stage/~RESET: J1.6, SW2.1, TP10.1, TP16.1, U1.40 (/RESET)
A0: U1.3 (PA02/EINT2/AIN0/Y0/VOUT); also elsewhere on the board
A1: U1.7 (PB08/I8/AIN2/SERCOM4.0); also elsewhere on the board
A2: U1.8 (PB09/I9/AIN3/SERCOM4.1); also elsewhere on the board
A3: U1.9 (PA04/EINT4/VREFB/AIN4/SERCOM0.0); also elsewhere on the board
A4: U1.10 (PA05/EINT5/AIN5/SERCOM0.1); also elsewhere on the board
A5: U1.47 (PB02/I2/AIN10/SERCOM5.0); also elsewhere on the board
D5: U1.24 (PA15/I15/SERCOM3+4.3); also elsewhere on the board
D6: U1.29 (PA20/I4/SERCOM3+5.2/I2SSC); also elsewhere on the board
D8: L1.2 (A), U1.11 (PA06/EINT6/AIN6/SERCOM0.2)
D9: U1.12 (PA07/I7/AIN7/SERCOM0.3/I2SD0); also elsewhere on the board
D13: L0.2 (A), U1.26 (PA17/I2C/I1/SERCOM1+3.1); also elsewhere on the board
D+: U1.34 (PA25/I13/SERCOM3+5.3/D+); also elsewhere on the board
D-: U1.33 (PA24/I12/SERCOM3+5.2/D-); also elsewhere on the board
GND: AUX_I2C0.1, B1.3 (-), C1.2, C2.2, C12.2, C14.2, C17.2, C18.2, C19.2, C23.2, C24.2, IC4.4 (VSS), J1.5, R13.2, R15.2, SCREEN0.4, SW2.2, TP17.1, U1.5 (GNDA), U1.18 (GND), U1.35 (GND), U1.42 (GND), U1.49 (GND), X4.6 (GND@3), X4.MT1 (GND@2), X4.MT2 (GND@1); also elsewhere on the board
unnamed: B1.2 (+), IC4.3 (VBAT)
unnamed: C1.1, IC4.8 (VDD), R6.2
unnamed: IC4.1 (XI), X1.1
unnamed: IC4.2 (XO), X1.4
unnamed: L0.1 (K), R15.1, TP8.1
unnamed: L1.1 (K), R21.2, TP7.1
unnamed: R13.1, R21.1
unnamed: C17.1, U1.1 (PA00/EINT0/SERCOM1.0), X2.1
unnamed: C18.1, U1.2 (PA01/EINT1/SERCOM1.1), X2.2
unnamed: C19.1, U1.43 (VDDCORE)
RX: U1.16 (PA11/I11/AIN19/SERCOM0+2.3/I2SF0); also elsewhere on the board
TX: U1.15 (PA10/I10/AIN18/SERCOM0+2.2/I2SCK); also elsewhere on the board

Notes on the sheet:
MICROSD CARD
Reset Switch
RTC

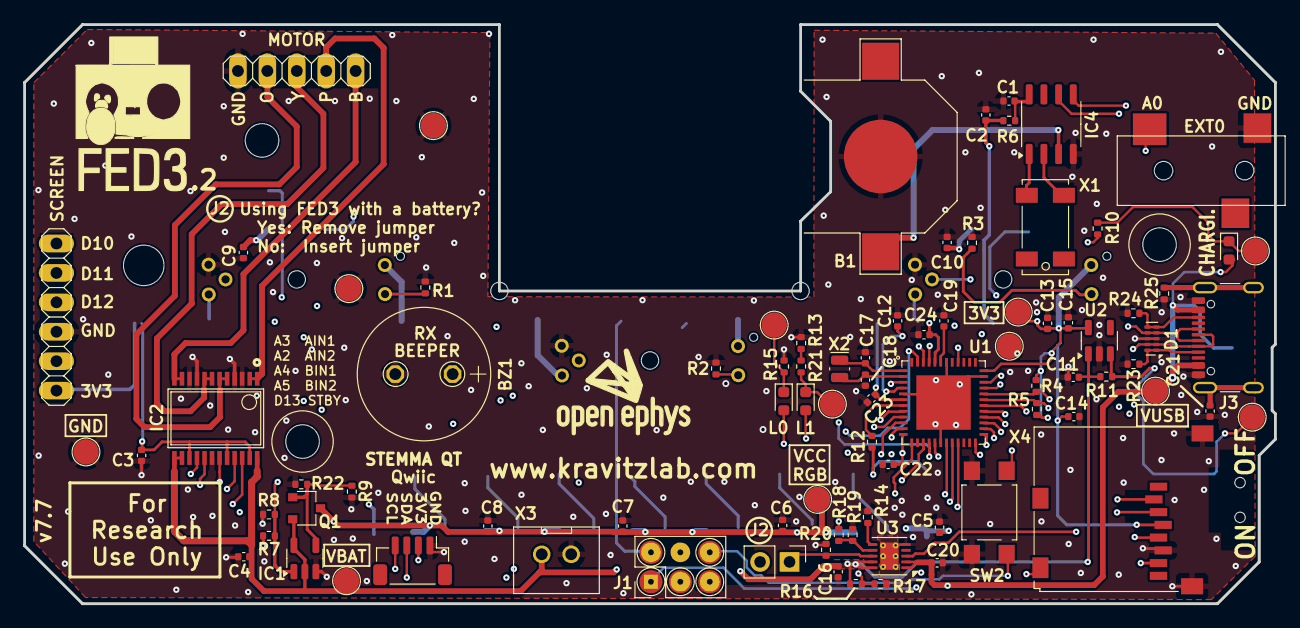
[picture p7: board FED3.kicad_pcb from above]

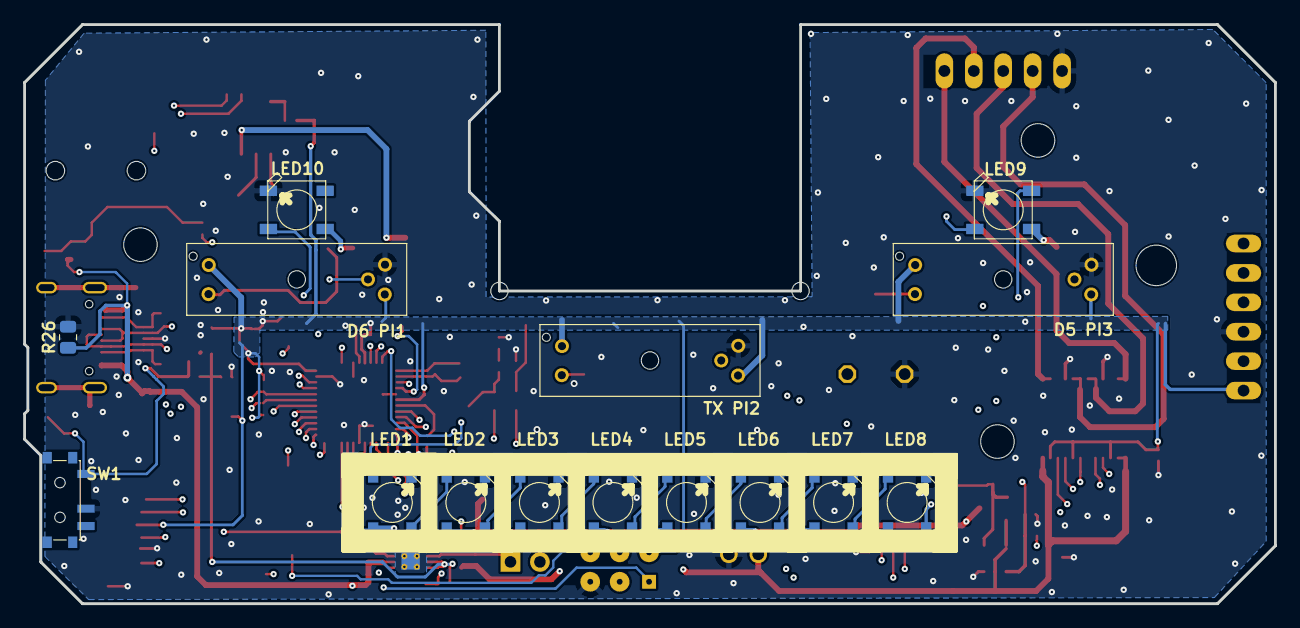
[picture p8: board FED3.kicad_pcb from below]

Board: 4 copper layers, 108.0 x 50.0 mm, 111 parts (15 on the bottom side), 71 nets.

Other parts of the board:
@HOLE0, @HOLE2, @HOLE2#2, @HOLE5, @HOLE6: (no value)
