davidpalma666/FED3.1-PCB-v7.x-FORK/pcb/_auxs/FED3.1 v7.2/FED3_v7.2 KICAD/FED3_v7.2.kicad_pcb

## KiCad design pcb/_auxs/FED3.1 v7.2/FED3_v7.2 KICAD/FED3_v7.2.kicad_pcb (2025-05-26)

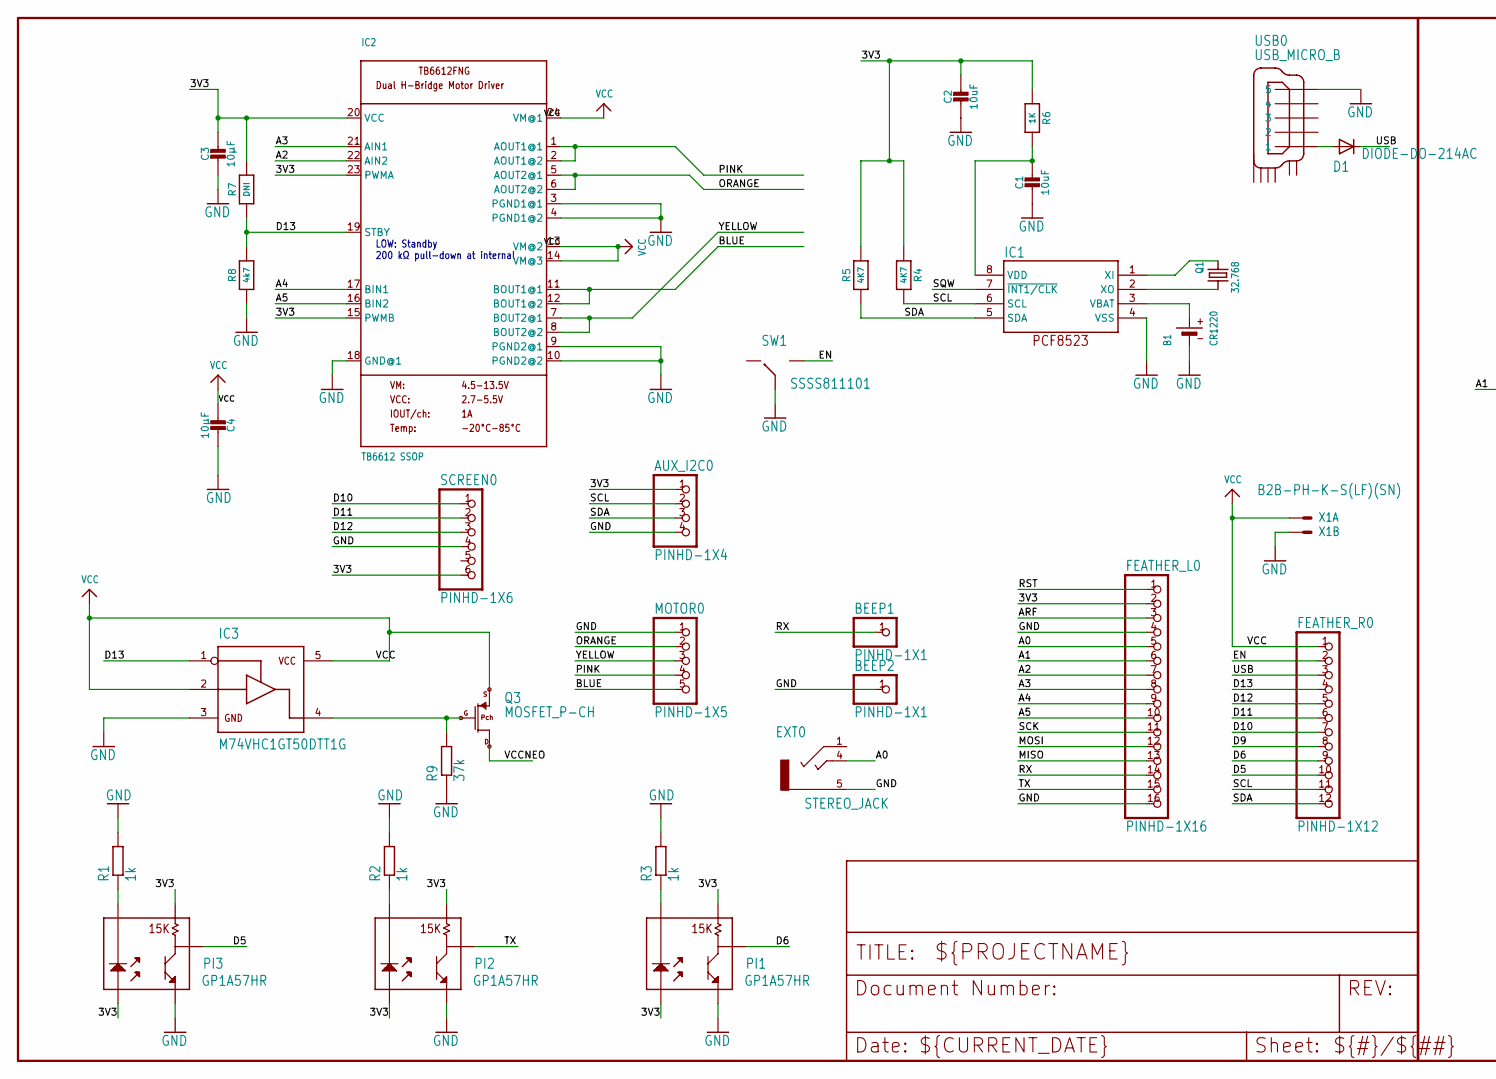
[picture p9: schematic FED3_v7.2.kicad_sch, part in row 1, column 1]

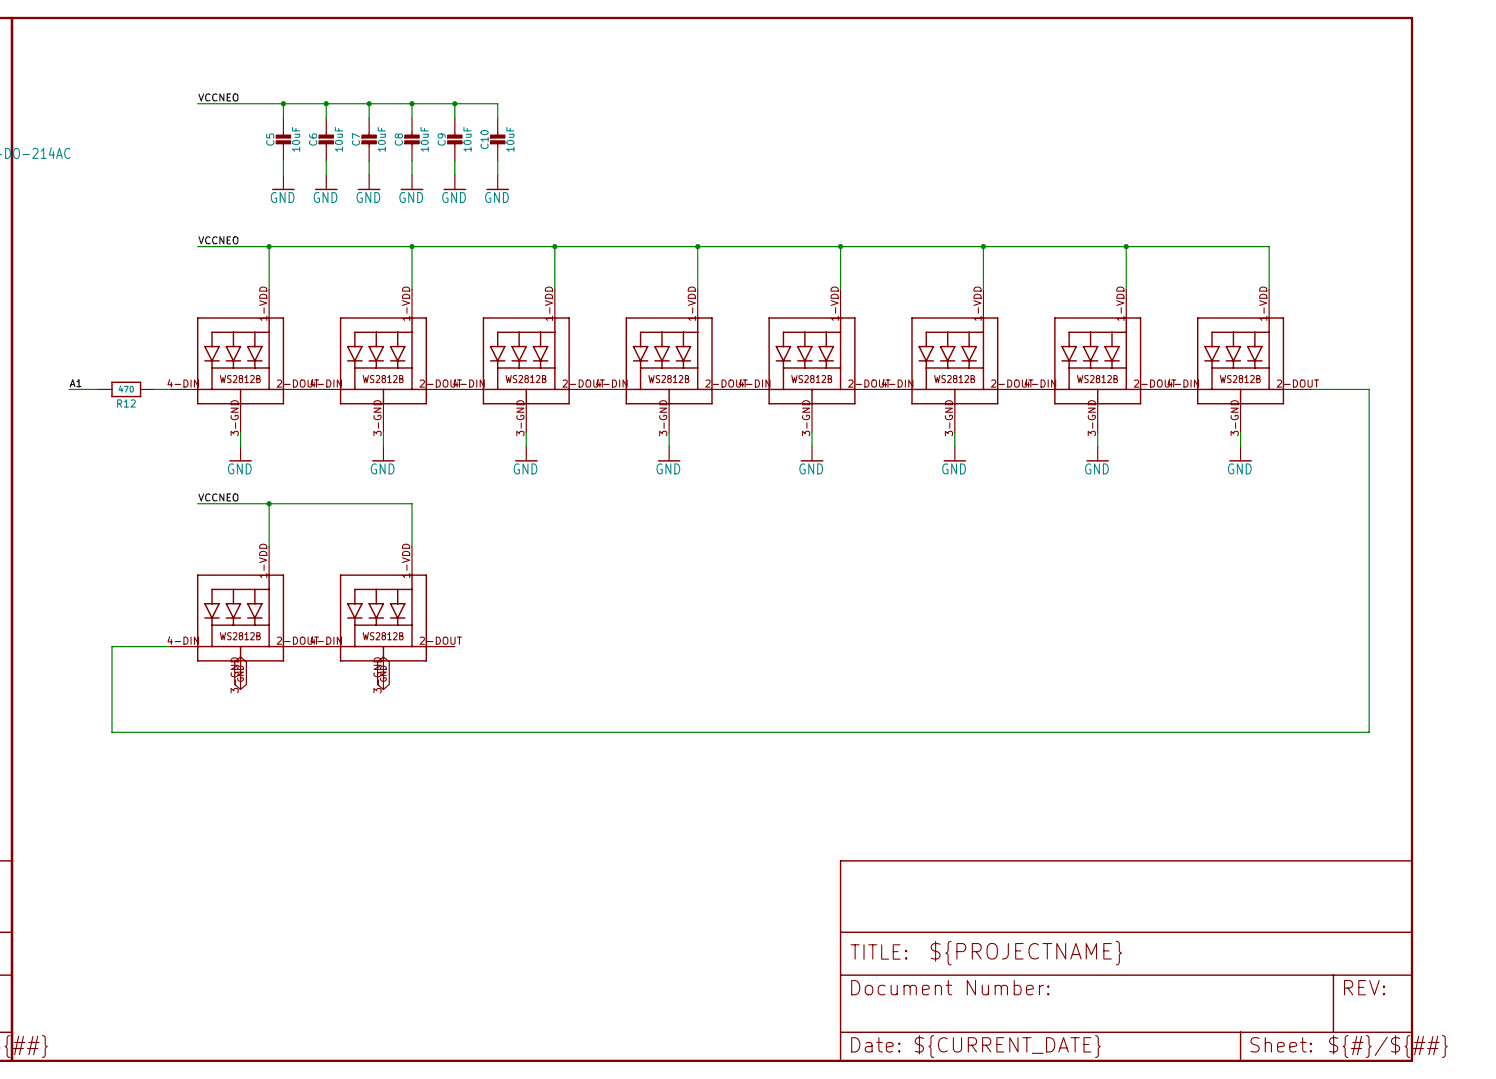
[picture p10: schematic FED3_v7.2.kicad_sch, part in row 1, column 2]

Parts:
AUX_I2C0: PINHD-1X4; 1X04
B1: CR1220
BEEP1, BEEP2: PINHD-1X1; 1X01
C1, C2, C5, C6, C7, C8, C9, C10: 10uF; 0805-NO
C3, C4: 10µF; 0805-NO
D1: DIODE-DO-214AC; DO-214AC
EXT0: STEREO_JACK; 35RASMT2BHNTRX
FEATHER_L0: PINHD-1X16; 1X16
FEATHER_R0: PINHD-1X12; 1X12
IC1: RTC_PCF8523T; SOIC8_150MIL
IC2: TB6612 SSOP; SSOP24
IC3: M74VHC1GT50DTT1G; SOT23-5
LED1, LED2, LED3, LED4, LED5, LED6, LED7, LED8, LED9, LED10: WS2812B5050; WS2812B
MOTOR0: PINHD-1X5; 1X05
PI1, PI2, PI3: GP1A57HR
Q1: 32.768; CRYSTAL_8X3.8
Q3: MOSFET_P-CH; TSMT3
R1, R2, R3: 1k; R0805
R4, R5: 4K7; 0805-NO
R6: 1K; 0805-NO
R7: DNI; 0805-NO
R8: 4k7; 0805-NO
R9: 37k; R0805
R12: 470; 0805-NO
SCREEN0: PINHD-1X6; 1X06
SW1: SSSS811101
USB0: USB_MICRO_B; ZX62D-B-5P8
X1: B2B-PH-K-S(LF)(SN); JST-XH-02-PACKAGE-ROUND-PAD

Connections:
3V3: AUX_I2C0.1, C2.1, C3.1, FEATHER_L0.2, IC2.15 (PWMB), IC2.20 (VCC), IC2.23 (PWMA), PI1.1, PI1.3, PI2.1, PI2.3, PI3.1, PI3.3, R4.1, R5.2, R6.1, R7.2, SCREEN0.6
A0: EXT0.4, FEATHER_L0.5
A1: FEATHER_L0.6, R12.2
A2: FEATHER_L0.7, IC2.22 (AIN2)
A3: FEATHER_L0.8, IC2.21 (AIN1)
A4: FEATHER_L0.9, IC2.17 (BIN1)
A5: FEATHER_L0.10, IC2.16 (BIN2)
ARF: FEATHER_L0.3
BLUE: IC2.11 (BOUT1@1), IC2.12 (BOUT1@2), MOTOR0.5
D5: FEATHER_R0.10, PI3.4
D6: FEATHER_R0.9, PI1.4
D9: FEATHER_R0.8
D10: FEATHER_R0.7, SCREEN0.1
D11: FEATHER_R0.6, SCREEN0.2
D12: FEATHER_R0.5, SCREEN0.3
D13: FEATHER_R0.4, IC2.19 (STBY), IC3.1, R7.1, R8.2
EN: FEATHER_R0.2, SW1.3
GND: AUX_I2C0.4, B1.-, BEEP2.1, C1.2, C2.2, C3.2, C4.2, C5.2, C6.2, C7.2, C8.2, C9.2, C10.2, EXT0.5, FEATHER_L0.4, FEATHER_L0.16, IC1.4 (VSS), IC2.3 (PGND1@1), IC2.4 (PGND1@2), IC2.9 (PGND2@1), IC2.10 (PGND2@2), IC2.18 (GND@1), IC3.3, LED1.3-GND (GND), LED2.3-GND (GND), LED3.3-GND (GND), LED4.3-GND (GND), LED5.3-GND (GND), LED6.3-GND (GND), LED7.3-GND (GND), LED8.3-GND (GND), LED9.3-GND (GND), LED10.3-GND (GND), MOTOR0.1, PI1.5, PI2.5, PI3.5, R1.2, R2.2, R3.2, R8.1, R9.1, SCREEN0.4, SW1.2, USB0.P$5 (5), X1.1
MISO: FEATHER_L0.13
MOSI: FEATHER_L0.12
unnamed: PI2.2, R2.1
unnamed: PI3.2, R1.1
unnamed: PI1.2, R3.1
unnamed: D1.A, USB0.P$1 (1)
unnamed: LED1.2-DOUT (DO), LED2.4-DIN (DI)
unnamed: C1.1, IC1.8 (VDD), R6.2
unnamed: LED2.2-DOUT (DO), LED3.4-DIN (DI)
unnamed: LED3.2-DOUT (DO), LED4.4-DIN (DI)
unnamed: LED4.2-DOUT (DO), LED5.4-DIN (DI)
unnamed: LED5.2-DOUT (DO), LED6.4-DIN (DI)
unnamed: LED6.2-DOUT (DO), LED7.4-DIN (DI)
unnamed: LED7.2-DOUT (DO), LED8.4-DIN (DI)
unnamed: IC1.1 (XI), Q1.P$1 (1)
unnamed: IC1.2 (XO), Q1.P$4 (2)
unnamed: LED1.4-DIN (DI), R12.1
unnamed: LED9.2-DOUT (DO), LED10.4-DIN (DI)
unnamed: LED8.2-DOUT (DO), LED9.4-DIN (DI)
ORANGE: IC2.5 (AOUT2@1), IC2.6 (AOUT2@2), MOTOR0.2
OUT3: IC3.4, Q3.P$1 (G), R9.2
PINK: IC2.1 (AOUT1@1), IC2.2 (AOUT1@2), MOTOR0.4
RST: FEATHER_L0.1
RX: BEEP1.1, FEATHER_L0.14
SCK: FEATHER_L0.11
SCL: AUX_I2C0.2, FEATHER_R0.11, IC1.6 (SCL), R4.2
SDA: AUX_I2C0.3, FEATHER_R0.12, IC1.5 (SDA), R5.1
SQW: IC1.7 (~INT1/CLK)
TX: FEATHER_L0.15, PI2.4
USB: D1.C, FEATHER_R0.3
VBAT1: B1.+$1 (+), IC1.3 (VBAT)
VCC: C4.1, FEATHER_R0.1, IC2.13 (VM@2), IC2.14 (VM@3), IC2.24 (VM@1), IC3.2, IC3.5, Q3.P$2 (S), X1.2
VCCNEO: C5.1, C6.1, C7.1, C8.1, C9.1, C10.1, LED1.1-VDD (VDD), LED2.1-VDD (VDD), LED3.1-VDD (VDD), LED4.1-VDD (VDD), LED5.1-VDD (VDD), LED6.1-VDD (VDD), LED7.1-VDD (VDD), LED8.1-VDD (VDD), LED9.1-VDD (VDD), LED10.1-VDD (VDD), Q3.P$3 (D)
YELLOW: IC2.7 (BOUT2@1), IC2.8 (BOUT2@2), MOTOR0.3

Notes on the sheet:
LOW: Standby 200 kΩ pull-down at internal

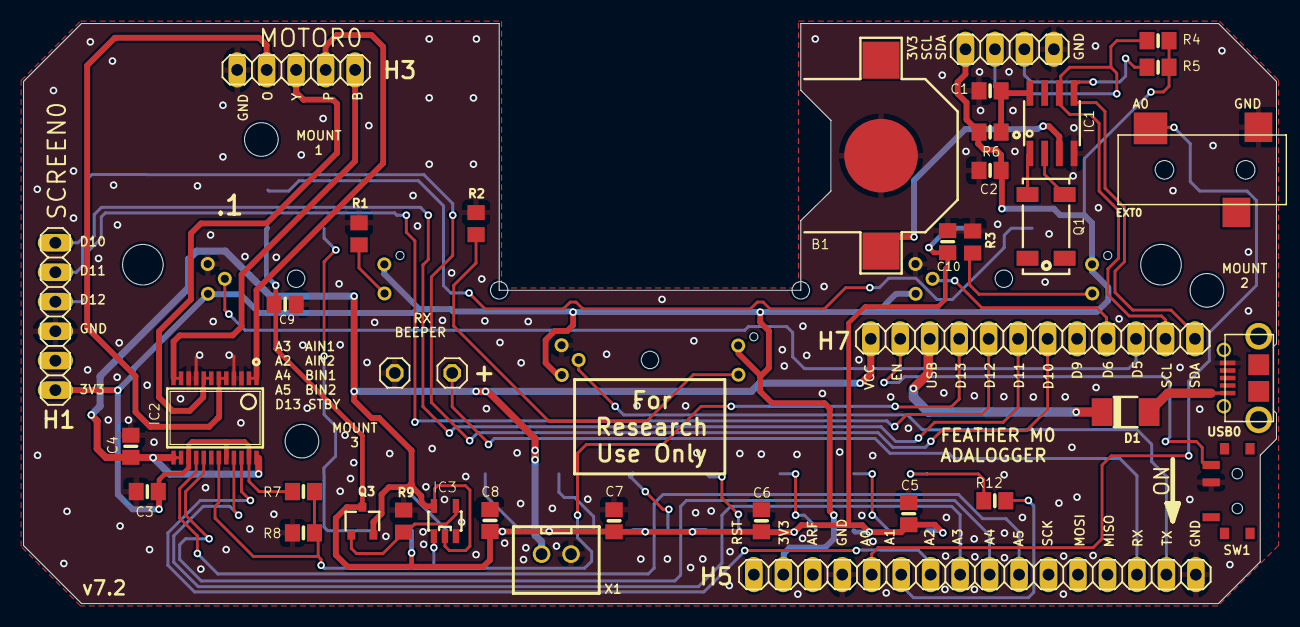
[picture p11: board FED3_v7.2.kicad_pcb from above]

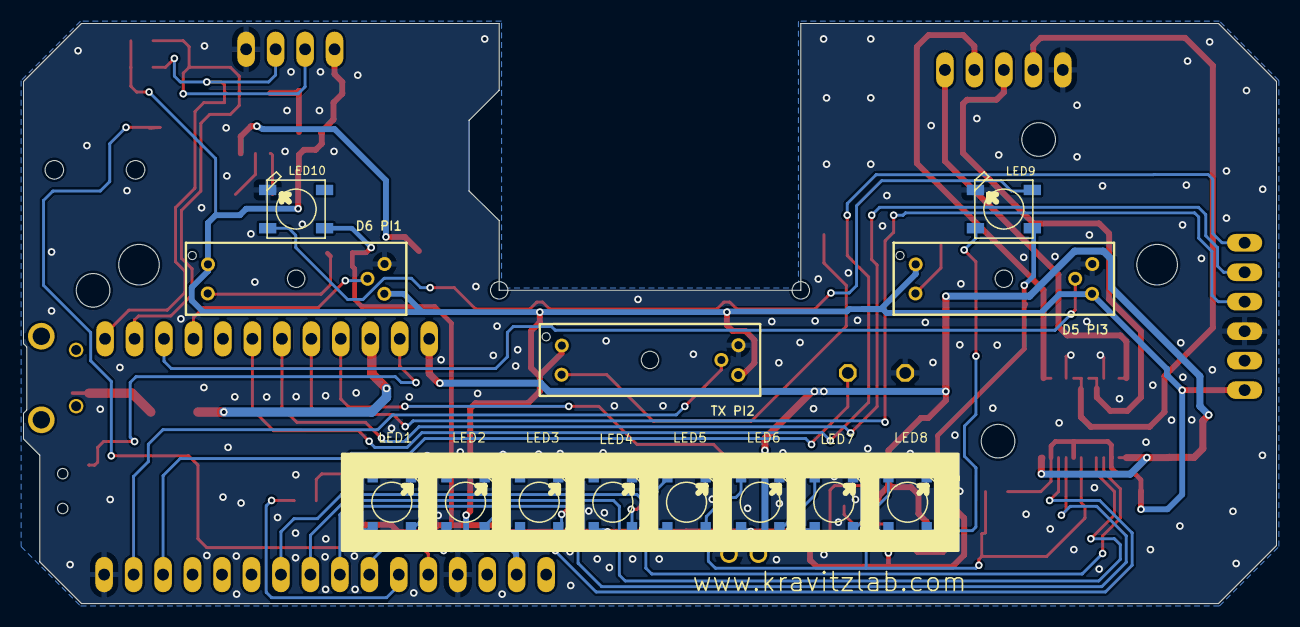
[picture p12: board FED3_v7.2.kicad_pcb from below]

Board: 2 copper layers, 108.0 x 50.0 mm, 58 parts (13 on the bottom side), 45 nets.

Other parts of the board:
@HOLE0, @HOLE1, @HOLE2, @HOLE3, @HOLE4, @HOLE5, @HOLE6: (no value)
