davidpalma666/FED3.1-PCB-v7.x-FORK/(commit log)

2025-05-26 older version 7.2
    [FED3_v7.2.brd, FED3_v7.2.kicad_pcb, FED3_v7.2.kicad_sch, FED3_v7.2.sch]
2025-05-29 project folders reorganized
    [FED3.kicad_pcb, FED3.kicad_sch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]
2025-05-29 FED3 v7.4 - 1st step finished to review
    - U2 MPN & OEPSPN changed
    - X2 case corrected
    - USB D+ & D- corrected on USB-plug
    - manufacturer & BOM files still missing
    [FED3.kicad_pcb, FED3.kicad_sch]
2025-06-03 review step 2
    Realocação de labels e refªs:
    - sem qq alteração no circuito
    - alteração na PCB apenas a ver com alocação de Designators/SilkScreen parts
    [FED3.kicad_pcb, FED3.kicad_sch, IOs Interface.kicad_sch, controler stage.kicad_sch]
2025-06-04 buzzer step model updated
    [FED3.kicad_pcb]
2025-06-05 get tunning with main branch
    [FED3.kicad_pcb, FED3.kicad_sch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]
2025-06-06 v.7.4 - alterações rail power
    v.7.4
    - modificada estrutura rail power: VUSB apenas para Vcharging
    - modificadas Rs de LEDs para diminuir I
    [FED3.kicad_pcb, FED3.kicad_sch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]
2025-06-09 v.7.4 - commit to final review
    - I2C plug moved to board front side
    - Rs to LEDs changed - impose less I
    [FED3.kicad_pcb, FED3.kicad_sch, IOs Interface.kicad_sch, controler stage.kicad_sch]
2025-06-11 FED3 v7.3 - 2nd revision
    [FED3.kicad_pcb, FED3.kicad_sch, controler stage.kicad_sch]
2025-06-12 modificados valores R14 R20: 2k2
    [FED3.kicad_pcb, FED3.kicad_sch]
2025-06-12 R20 off; R14=2k2
    [FED3.kicad_pcb, FED3.kicad_sch]
2025-06-25 gerados Gerbers&Drills
    [FED3-B_Cu.gbr, FED3-B_Mask.gbr, FED3-B_Paste.gbr, FED3-B_Silkscreen.gbr, FED3-Edge_Cuts.gbr, FED3-F_Cu.gbr, FED3-F_Mask.gbr, FED3-F_Paste.gbr]
2025-06-25 BOM & Pick&Place
    [BOM FED3.csv, FED3.kicad_pcb]
2025-06-25 retomar sincronia PCB com main-branch @12Junho
    [BOM FED3.csv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]
2025-06-25 adicionados ficheiros de produção
    - Gerbers & Drills
    - Pick & Place
    - BOM
    [FED3 v.7.4 BOM.csv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]
2025-06-26 actualizados ficheiros produção
    - modificadas props de componentes para agilizar o criar ficheiros de produção
    [FED3 v.7.4 BOM.csv, FED3.kicad_pcb, FED3.kicad_sch, controler stage.kicad_sch]
2025-07-03 getting tunned with Jonathan review #13
    [FED3 v.7.4 BOM.csv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]
2025-07-03 last tunnings
    - Top & Bottom Fabrication Layers tuned
    - generated Gerbers&Drills files
    - generated P&P & BOM files
    [FED3 BOM.csv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]
2025-07-07 'ultima versão revista; não em tunning com a versão oficial /Kravitz/FED3
    [BOM.xlsx, FED3 BOM.csv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]
2025-07-31 FED3 v.7.5
    - nova ficha USB C
    - andar carregador da pilha passa para capacidade carga 780mA
    [BOM.xlsx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]
2025-08-01 FED3 v.7.5 - 1ºs ficheiros de progução
    - adicionada header para opção VTherm = Vbat
    - optimização para BOM: variedade-vs-quantidade
    - optimização de power-planes
    - gerados ficheiros produção para 1ª avaliação; há lá erros reconhecidos
    [BOM.xlsx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]
2025-08-01 FED3 v.7.5 - 2ºs ficheiros produção
    - corrigidas posições de silks de alguns componentes
    - modificados Denominators de alguns componentes
    [FED3-B_Courtyard.gbr, FED3-B_Cu.gbr, FED3-B_Fab.gbr, FED3-B_Mask.gbr, FED3-B_Paste.gbr, FED3-B_Silkscreen.gbr, FED3-Edge_Cuts.gbr, FED3-F_Courtyard.gbr]
2025-08-26 sincronia com a v.7.6 em produção
    [BOM.xlsx, FED3 BOM.csv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]
2025-08-26 Revert "sincronia com a v.7.6 em produção"
    This reverts commit 4ea7ff216a6da1369a32485a5f5775c3091efbbe.
    [BOM.xlsx, FED3 BOM.csv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]
2025-08-26 Reapply "sincronia com a v.7.6 em produção"
    This reverts commit 366851c8e0f049044401f28871b7d8940161753b.
    [BOM.xlsx, FED3 BOM.csv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]
2025-10-15 em tunning com main-branch
    [FED3 BOM.csv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]
2025-10-29 adicionada folder de \_fw ao commited
    [variant_atmel_edbg.cfg]
2025-12-12 PUp de Battery Charge
    - modificado valor R18 - R para setup de I Batt charge
    - actualizada PCB & BOM
    [FED3 BOM.csv, FED3.kicad_pcb, FED3.kicad_sch]
2026-02-04 adicionadas placas para teste de FED3
    . "FED tester" - projecto com circuito de teste & PCB ainda não finalizada
    . "FED3 tester base - support"- projecto sem circuito; PCB para questão mecânica de fixação & alihamento agulhas:
    . "FED3 tester 1st production aux" - projecto com base do "FED tester" mas sem componentes: para 1ºs testes mecânicos
    [DUT.kicad_sch, FED3 as is novos TP mirrored.kicad_pcb, FED3 as is novos TP mirrored.kicad_sch, FED3 as is novos TP.kicad_pcb, FED3 as is novos TP.kicad_sch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]
2026-02-04 alteração no nome do projecto "FED3 tester - support"
    . gerados novos Gerbers & Drill & .d356
    [FED3 tester - support-B_Courtyard.gbr, FED3 tester - support-B_Cu.gbr, FED3 tester - support-B_Fab.gbr, FED3 tester - support-B_Mask.gbr, FED3 tester - support-B_Paste.gbr, FED3 tester - support-B_Silkscreen.gbr, FED3 tester - support-Edge_Cuts.gbr, FED3 tester - support-F_Courtyard.gbr]
2026-02-12 FED3 Tester - 1º routing finalizado
    [DUT.kicad_sch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]
2026-02-20 FED3-tester
    - 'final' - antes de revisão com o Filipe
    [DUT.kicad_sch, FED3 tester.kicad_pcb, FED3 tester.kicad_sch, main core.kicad_sch]
2026-03-05 FED 3 tester - actualizados novos OEPSPN & MPN; ainda 1 em falta
    [DUT.kicad_sch, FED3 tester.kicad_pcb, FED3 tester.kicad_sch, main core.kicad_sch]
2026-04-15 final tunning??
    - fields de componentes actualizados
    - trocada polaridade na ficha botão de emergência
    [DUT.kicad_sch, main core.kicad_sch]
2026-04-23 tunning com v.7.7
    [BOM.xlsx, DUT.kicad_sch, FED3 BOM.csv, FED3 tester.kicad_pcb, FED3 tester.kicad_sch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]
2026-04-24 início FED3 tester - rev.B
    [FED3 tester.kicad_pcb]
2026-04-29 FED3 tester project
    .commit para sincronia
    .ainda longe do final
    [FED3 tester.kicad_pcb, main core.kicad_sch]
2026-05-04 FED3 tester - sync of the week
    [DUT.kicad_sch, FED3 tester.kicad_pcb, FED3 tester.kicad_sch, main core.kicad_sch]
2026-05-06 FED3 tester rev.B & FED3 tester support rev.B
    -rev.B para 1ª revisão do Filipe
    [DUT.kicad_sch, FED3 tester - support.kicad_pcb, FED3 tester - support.kicad_sch, FED3 tester.kicad_pcb, FED3 tester.kicad_sch, main core.kicad_sch]
2026-05-07 adicionadas stitching-vias a planos GND
    nota:
    - não tem plano GND no top-layer, pq o attach-to-pads é sempre feito a 0.5mm independentemente do setup q se faça no plano;
    (algo já reportado com Kicad-bug em v10.0)
    - haveria situações em q entrava em conflito com pitch de componentes; tamanho de pads etc
    [FED3 tester.kicad_pcb]
2026-05-11 State LED - modificada côr para amarelo
    [FED3 tester.kicad_pcb, main core.kicad_sch]
2026-05-14 completos OEPSPN & MPN
    - andar de I-measure ZXCT1086 redimensionado
    [DUT.kicad_sch, FED3 as is novos TP.kicad_pcb, FED3 as is novos TP.kicad_sch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]
2026-05-14 revistos OEPSPN & MPN com gsheet - OK
    [DUT.kicad_sch, FED3 tester.kicad_pcb, FED3 tester.kicad_sch, main core.kicad_sch]
2026-05-14 corrigidas distâncias Labels-&-Botões
    [FED3 tester.kicad_pcb]
2026-05-15 criado repo para boards de tester; tiradas deste projecto
    [DUT.kicad_sch, FED3 as is novos TP mirrored.kicad_pcb, FED3 as is novos TP mirrored.kicad_sch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]
